jackamsbry/Crabbot/Mechanical/Solidworks Models/Crab_Assembly.SLDASM

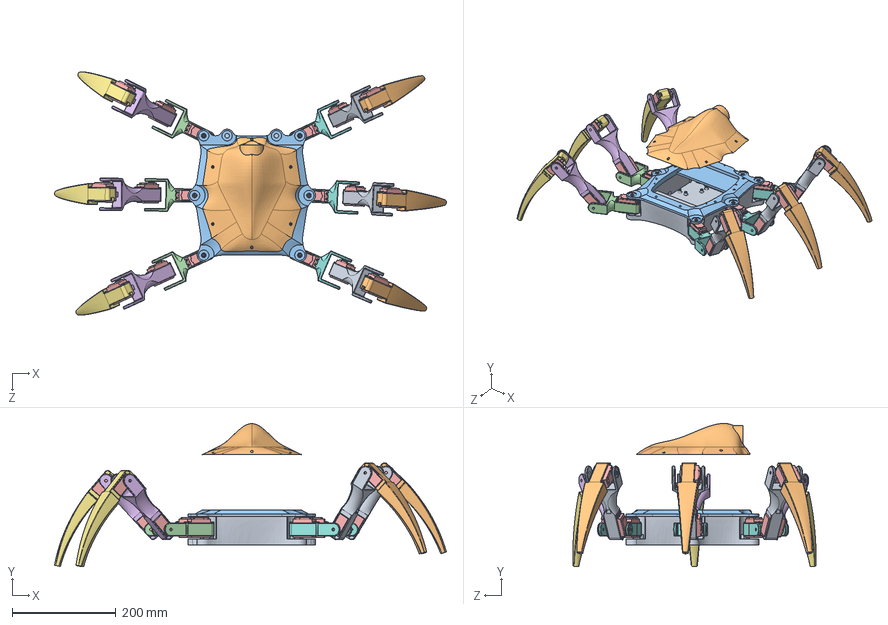
[picture p1: CAD file, 2020-10-20]
Mechanical/Solidworks Models/Crab_Assembly.SLDASM
754.6 x 275.5 x 468.6 mm
BodyBase
BodyMotorMountTop
BodyMotorMountBottom
Coxa_left x 3
TowerPro_MG995 x 18
Femur_left x 3
Tibia_left x 3
Coxa_right x 3
Femur_right x 3
Tibia_right x 3
Eye_IrisDark
Eye_IrisClear
