jackamsbry/Crabbot/Mechanical/Solidworks Models/leg_assembly_left.SLDASM

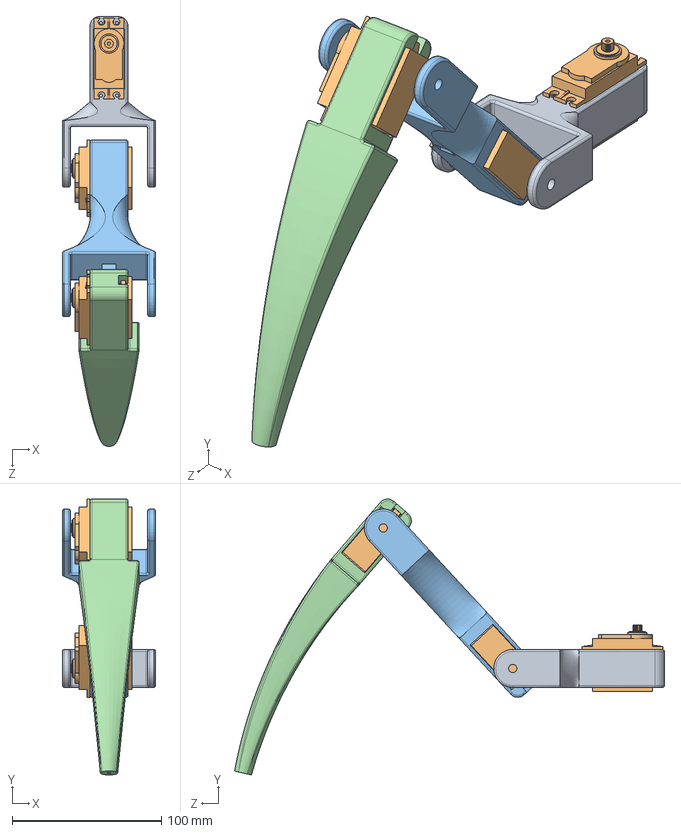
[picture p2: CAD file, 2020-10-08]
Mechanical/Solidworks Models/leg_assembly_left.SLDASM
62.5 x 184.8 x 287.9 mm
Coxa_left
TowerPro_MG995 x 3
Femur_left
Tibia_left
