jackamsbry/Crabbot/Mechanical/Solidworks Models/leg_assembly_right.SLDASM

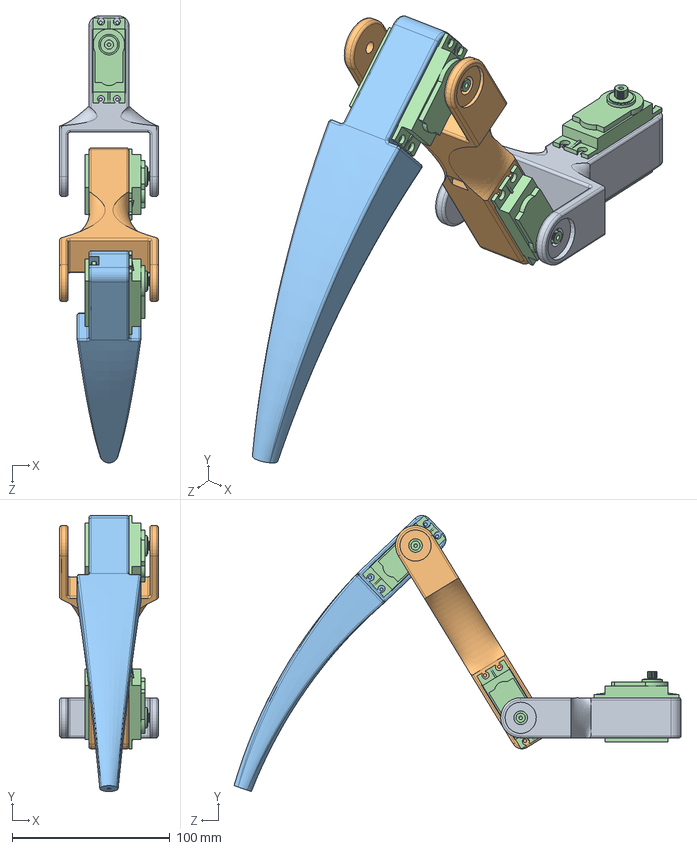
[picture p3: CAD file, 2020-10-08]
Mechanical/Solidworks Models/leg_assembly_right.SLDASM
62.5 x 175.0 x 283.3 mm
Coxa_right
Femur_right
Tibia_right
TowerPro_MG995 x 3
