jackamsbry/Crabbot/Mechanical/Solidworks Models/eye_assembly.SLDASM

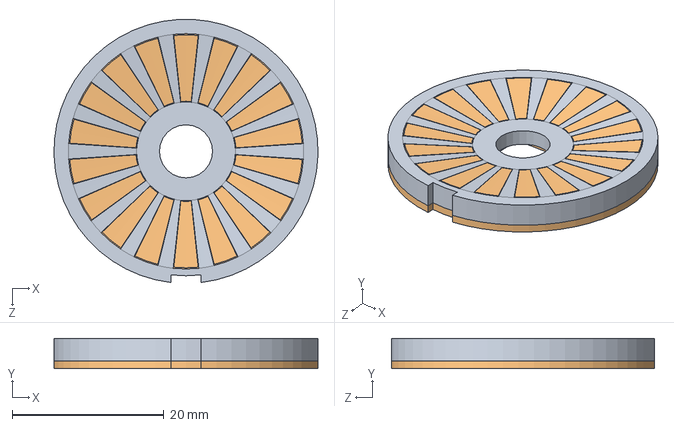
[picture p4: CAD file, 2020-10-08]
Mechanical/Solidworks Models/eye_assembly.SLDASM
34.8 x 4.00 x 34.7 mm
Eye_IrisDark
Eye_IrisClear
