jackamsbry/Crabbot/Mechanical/Solidworks Models/Femur_left.SLDPRT

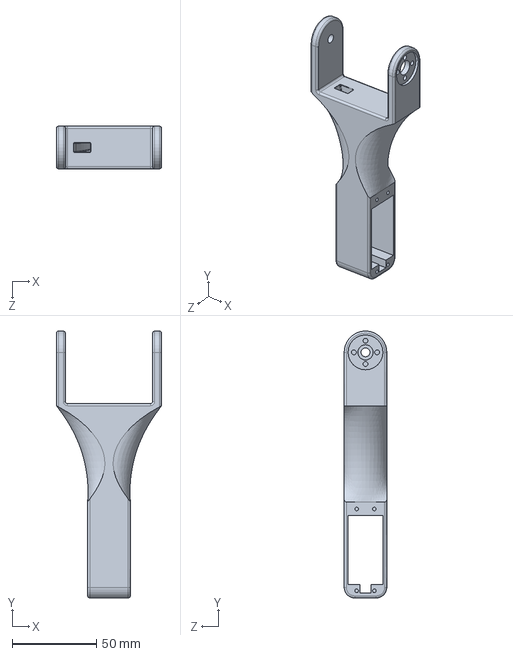
[picture p5: CAD file, 2020-12-05]
Mechanical/Solidworks Models/Femur_left.SLDPRT
62.5 x 158.8 x 25.4 mm
