jackamsbry/Crabbot/Mechanical/Solidworks Models/Coxa_left.SLDPRT

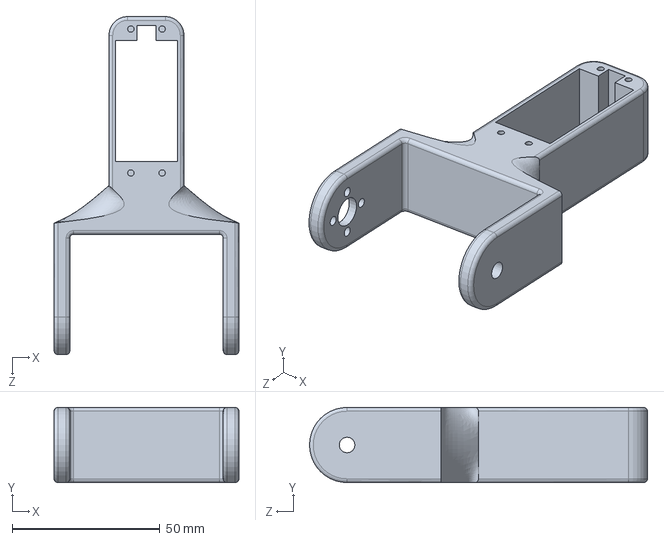
[picture p6: CAD file, 2020-12-02]
Mechanical/Solidworks Models/Coxa_left.SLDPRT
62.5 x 25.4 x 114.3 mm
