jackamsbry/Crabbot/Mechanical/Solidworks Models/BodyMotorMountBottom.SLDPRT

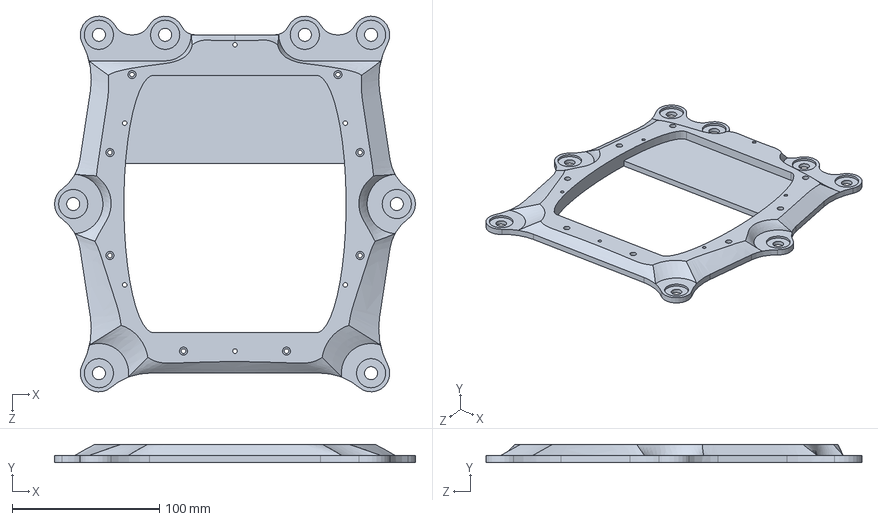
[picture p7: CAD file, 2020-10-20]
Mechanical/Solidworks Models/BodyMotorMountBottom.SLDPRT
245.4 x 12.5 x 255.4 mm
