jackamsbry/Crabbot/Mechanical/Solidworks Models/BodyMotorMountTop.sldprt

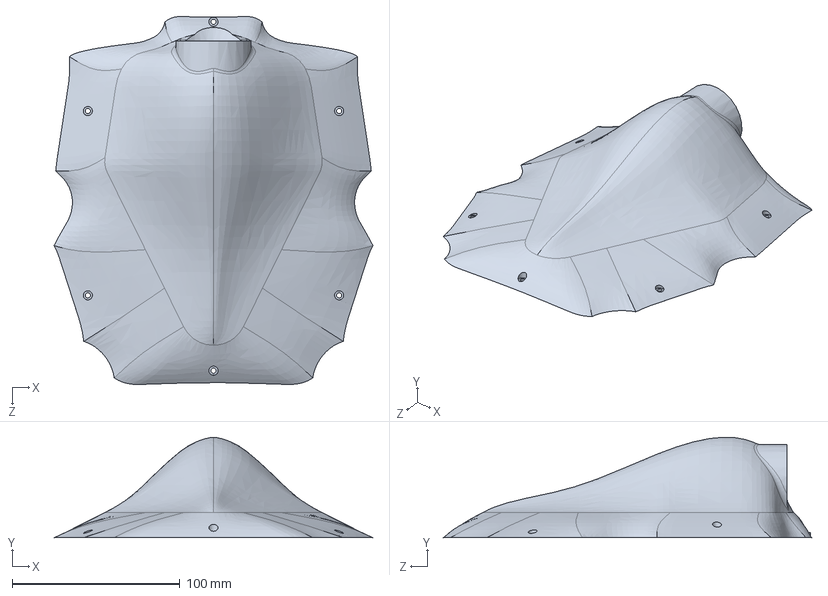
[picture p8: CAD file, 2020-10-20]
Mechanical/Solidworks Models/BodyMotorMountTop.sldprt
190.4 x 60.0 x 219.7 mm
