jackamsbry/Crabbot/Mechanical/Solidworks Models/BodyMotorMount.SLDPRT

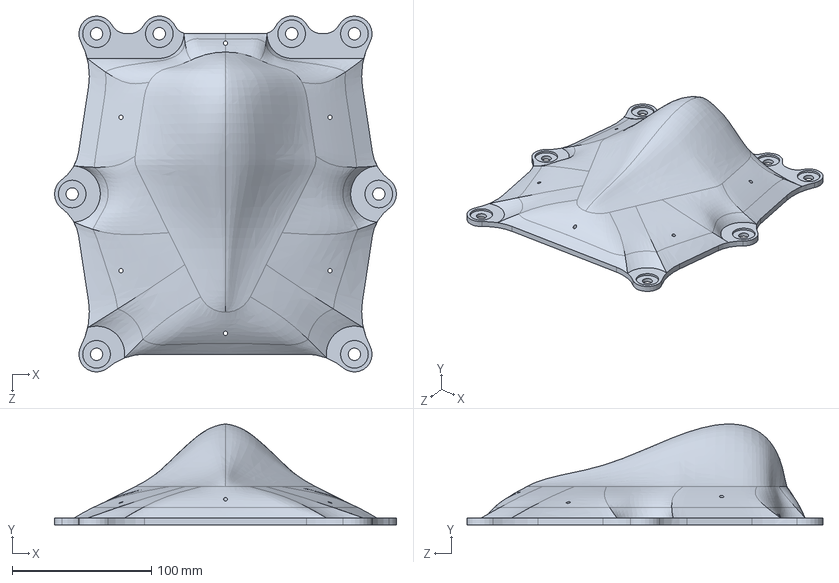
[picture p9: CAD file, 2020-10-20]
Mechanical/Solidworks Models/BodyMotorMount.SLDPRT
245.4 x 72.5 x 255.4 mm
