jackamsbry/Crabbot/Mechanical/Solidworks Models/BodyBase.SLDPRT

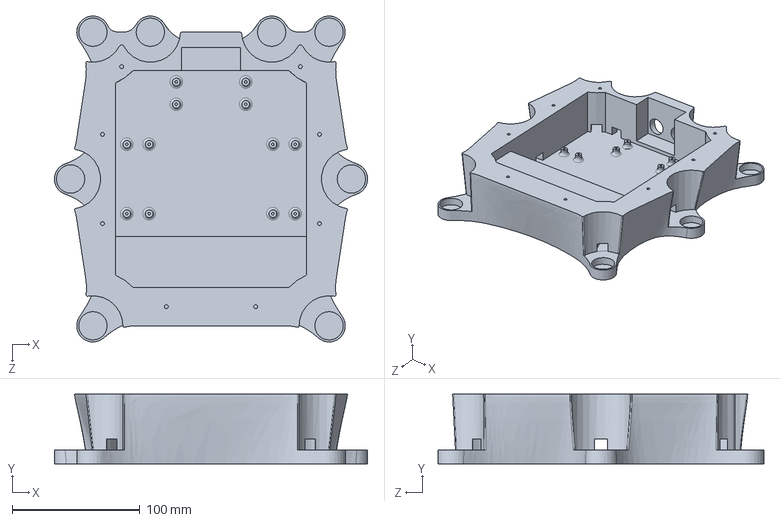
[picture p10: CAD file, 2020-10-20]
Mechanical/Solidworks Models/BodyBase.SLDPRT
245.3 x 54.8 x 255.4 mm
