jackamsbry/Crabbot/Mechanical/Solidworks Models/Eye_IrisDark.SLDPRT

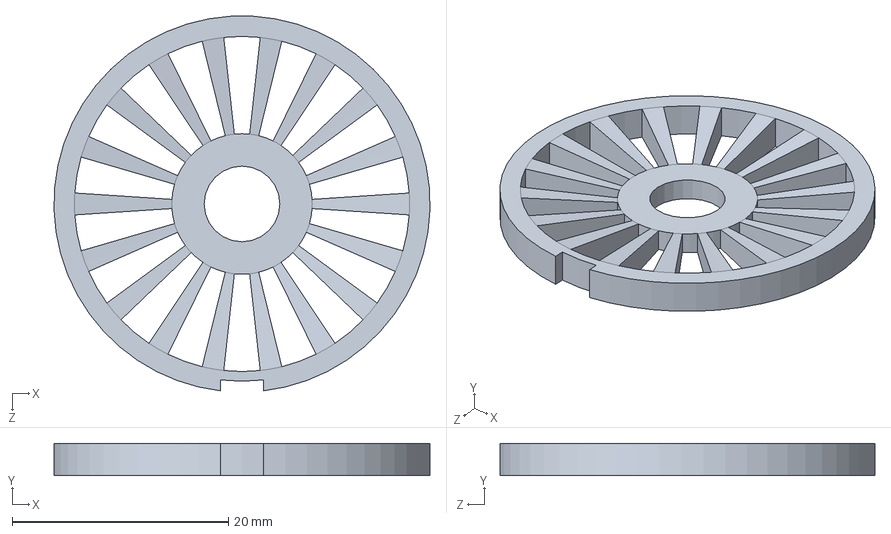
[picture p11: CAD file, 2020-10-08]
Mechanical/Solidworks Models/Eye_IrisDark.SLDPRT
34.8 x 3.00 x 34.7 mm
