jackamsbry/Crabbot/Mechanical/Solidworks Models/Tibia_left.SLDPRT

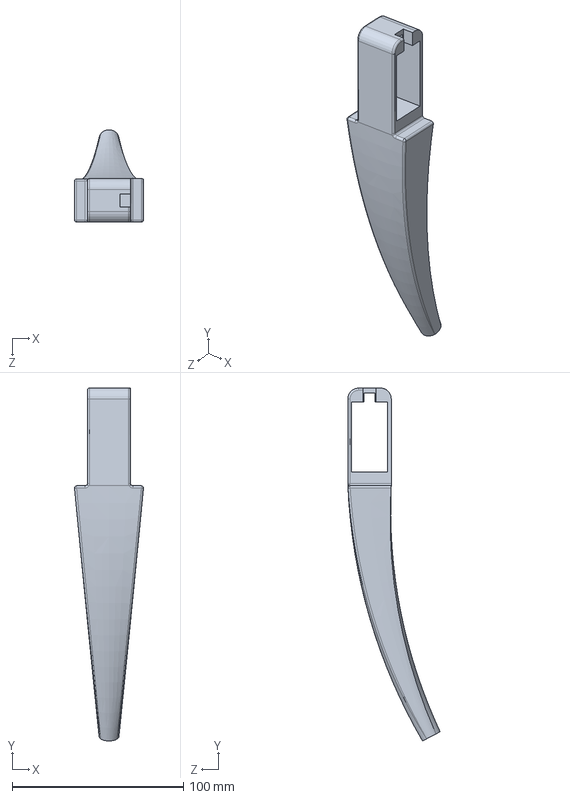
[picture p12: CAD file, 2020-10-08]
Mechanical/Solidworks Models/Tibia_left.SLDPRT
40.4 x 206.4 x 54.0 mm
