jackamsbry/Crabbot/Mechanical/Solidworks Models/coxa_servo_back.SLDPRT

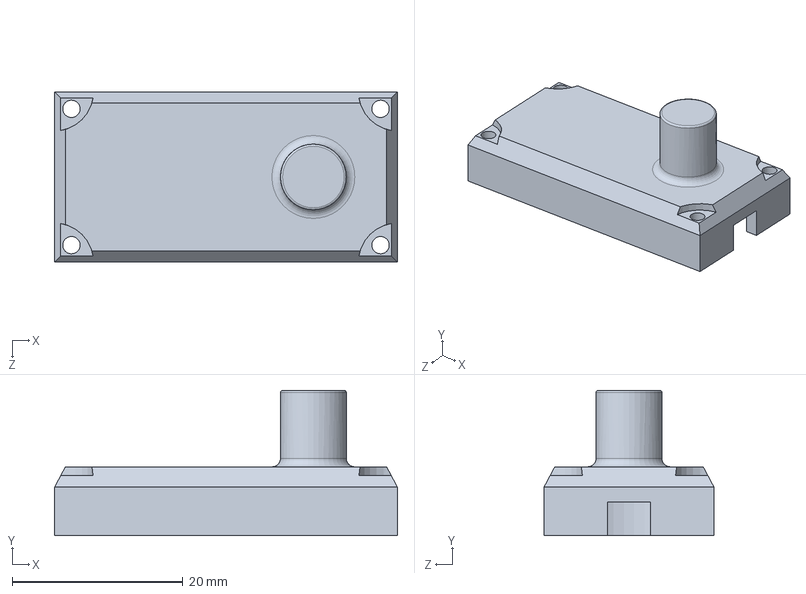
[picture p13: CAD file, 2020-10-08]
Mechanical/Solidworks Models/coxa_servo_back.SLDPRT
40.1 x 17.0 x 19.9 mm
