jackamsbry/Crabbot/Mechanical/Solidworks Models/Eye_IrisClear.SLDPRT

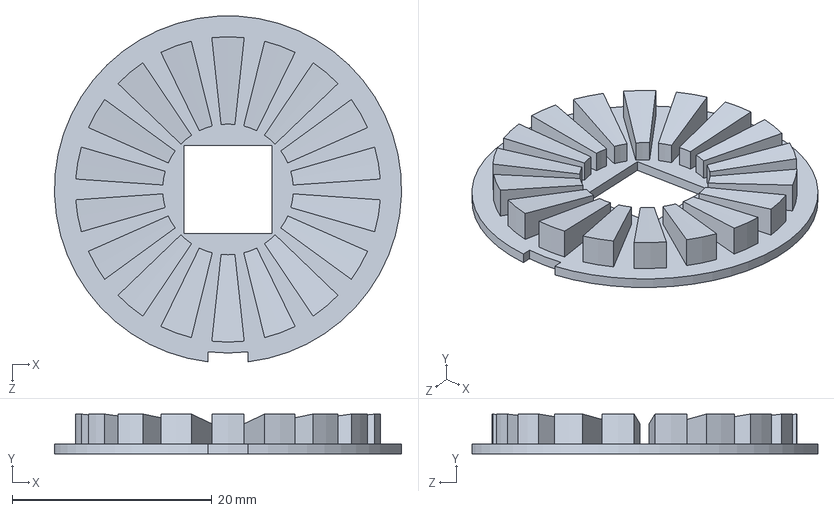
[picture p14: CAD file, 2020-10-08]
Mechanical/Solidworks Models/Eye_IrisClear.SLDPRT
34.8 x 4.00 x 34.7 mm
