jackamsbry/Crabbot/Mechanical/Solidworks Models/leg_servo_back.SLDPRT

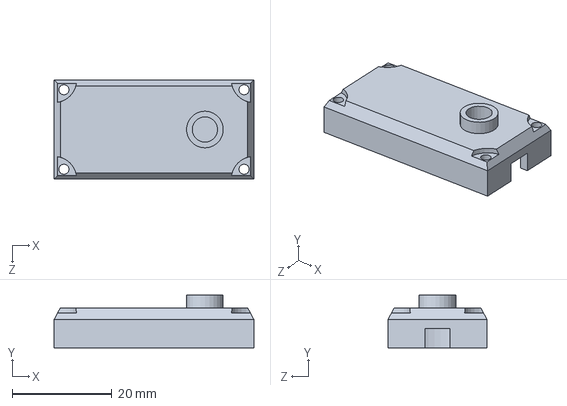
[picture p15: CAD file, 2020-10-05]
Mechanical/Solidworks Models/leg_servo_back.SLDPRT
40.1 x 10.6 x 19.9 mm
