jackamsbry/Crabbot/(list of files, cad)

Other CAD files:
Mechanical/Solidworks Models/Femur_right.SLDPRT
Mechanical/Solidworks Models/Coxa_right.SLDPRT
Mechanical/Solidworks Models/Tibia_right.SLDPRT
Mechanical/STLs/Coxa_left.STL
Mechanical/STLs/Coxa_right.STL
Mechanical/STLs/Femur_left.STL
Mechanical/STLs/Femur_right.STL
Mechanical/STLs/Tibia_left.STL
Mechanical/STLs/Tibia_right.STL
Mechanical/STLs/coxa_servo_back.STL
