jackamsbry/Crabbot/(commit log)

2020-03-31 added forward and inverse kinematics for legs
2020-04-07 changed inverse kinematics and step interpolation
2020-04-07 fixed forward and inverse kinematics
    [subsections.py]
2020-04-08 testing kinematics
2020-10-04 added solidworks models
    [BodyBase.SLDPRT, BodyMotorMount.SLDPRT, Coxa_left.SLDPRT, Coxa_right.SLDPRT, Crab_Assembly.SLDASM, Eye_IrisDark.SLDPRT, Femur_left.SLDPRT, Femur_right.SLDPRT]
2020-10-04 fixed front loft entity
    [BodyMotorMount.SLDPRT]
2020-10-04 changed main loft to boundary boss
    [BodyMotorMount.SLDPRT]
2020-10-04 Split Motor Mount into two parts
    [BodyMotorMount.SLDPRT, BodyMotorMountTop.sldprt]
2020-10-04 added opening on body top for eye
    [BodyMotorMount.SLDPRT, BodyMotorMountTop.sldprt]
2020-10-04 some small model shanges
    [BodyBase.SLDPRT, BodyMotorMount.SLDPRT, BodyMotorMountBottom.SLDPRT, BodyMotorMountTop.sldprt, Crab_Assembly.SLDASM]
2020-10-05 changed some hole dimensions
    [Coxa_right.SLDPRT, Crab_Assembly.SLDASM, Femur_left.SLDPRT, Femur_right.SLDPRT]
2020-10-05 added servo custom servo backs
    [coxa_servo_back.SLDPRT, leg_servo_back.SLDPRT]
2020-10-05 completed eye models
    [Eye_IrisClear.SLDPRT, Eye_IrisDark.SLDPRT]
2020-10-05 added battery mount hole
    [BodyBase.SLDPRT, BodyMotorMountBottom.SLDPRT, BodyMotorMountTop.sldprt]
2020-10-05 changed some dimensions
    [Coxa_left.SLDPRT]
2020-10-05 added tibia stls
    [Tibia_left.STL, Tibia_right.STL]
2020-10-05 add coxa servo back stl
    [coxa_servo_back.STL]
2020-10-06 updated body top
    [BodyBase.SLDPRT, BodyMotorMount.SLDPRT, BodyMotorMountBottom.SLDPRT, BodyMotorMountTop.sldprt]
2020-10-08 updated body top and created full robot assembly
    [BodyBase.SLDPRT, BodyMotorMountTop.sldprt, Coxa_left.SLDPRT, Crab_Assembly.SLDASM, Eye_IrisClear.SLDPRT, Eye_IrisDark.SLDPRT, Tibia_left.SLDPRT, coxa_servo_back.SLDPRT]
2020-10-20 changed mounting holes and added cuts for motor wires
    [BodyBase.SLDPRT]
2020-10-20 Update BodyMotorMountBottom.SLDPRT
    added mounting holes and cut for wires and weight
    [BodyMotorMountBottom.SLDPRT]
2020-10-20 Update BodyMotorMount.SLDPRT
    added hex screw holes
    [BodyMotorMount.SLDPRT]
2020-10-20 added hex mounting holes
    [BodyMotorMountBottom.SLDPRT, BodyMotorMountTop.sldprt]
2020-10-20 updated individual parts and some mates
    [Crab_Assembly.SLDASM]
2020-12-02 changed hole dimensions
    [Coxa_left.SLDPRT, Coxa_right.SLDPRT, Femur_left.SLDPRT, Femur_right.SLDPRT]
2020-12-02 added final leg stls
    [Coxa_left.STL, Coxa_right.STL, Femur_left.STL, Femur_right.STL]
2020-12-05 fixed motor wire hole dimensions
    [Femur_left.SLDPRT, Femur_right.SLDPRT]
